Unipuls80/Unidisp/README.md

# Unidisp
Výrobní podklady pro univerzální displej s digitrony, obstarávající napájení a buzení.
