Unipuls80/Unidisp/display_board.kicad_pcb

## KiCad design display_board.kicad_pcb (2023-02-11)

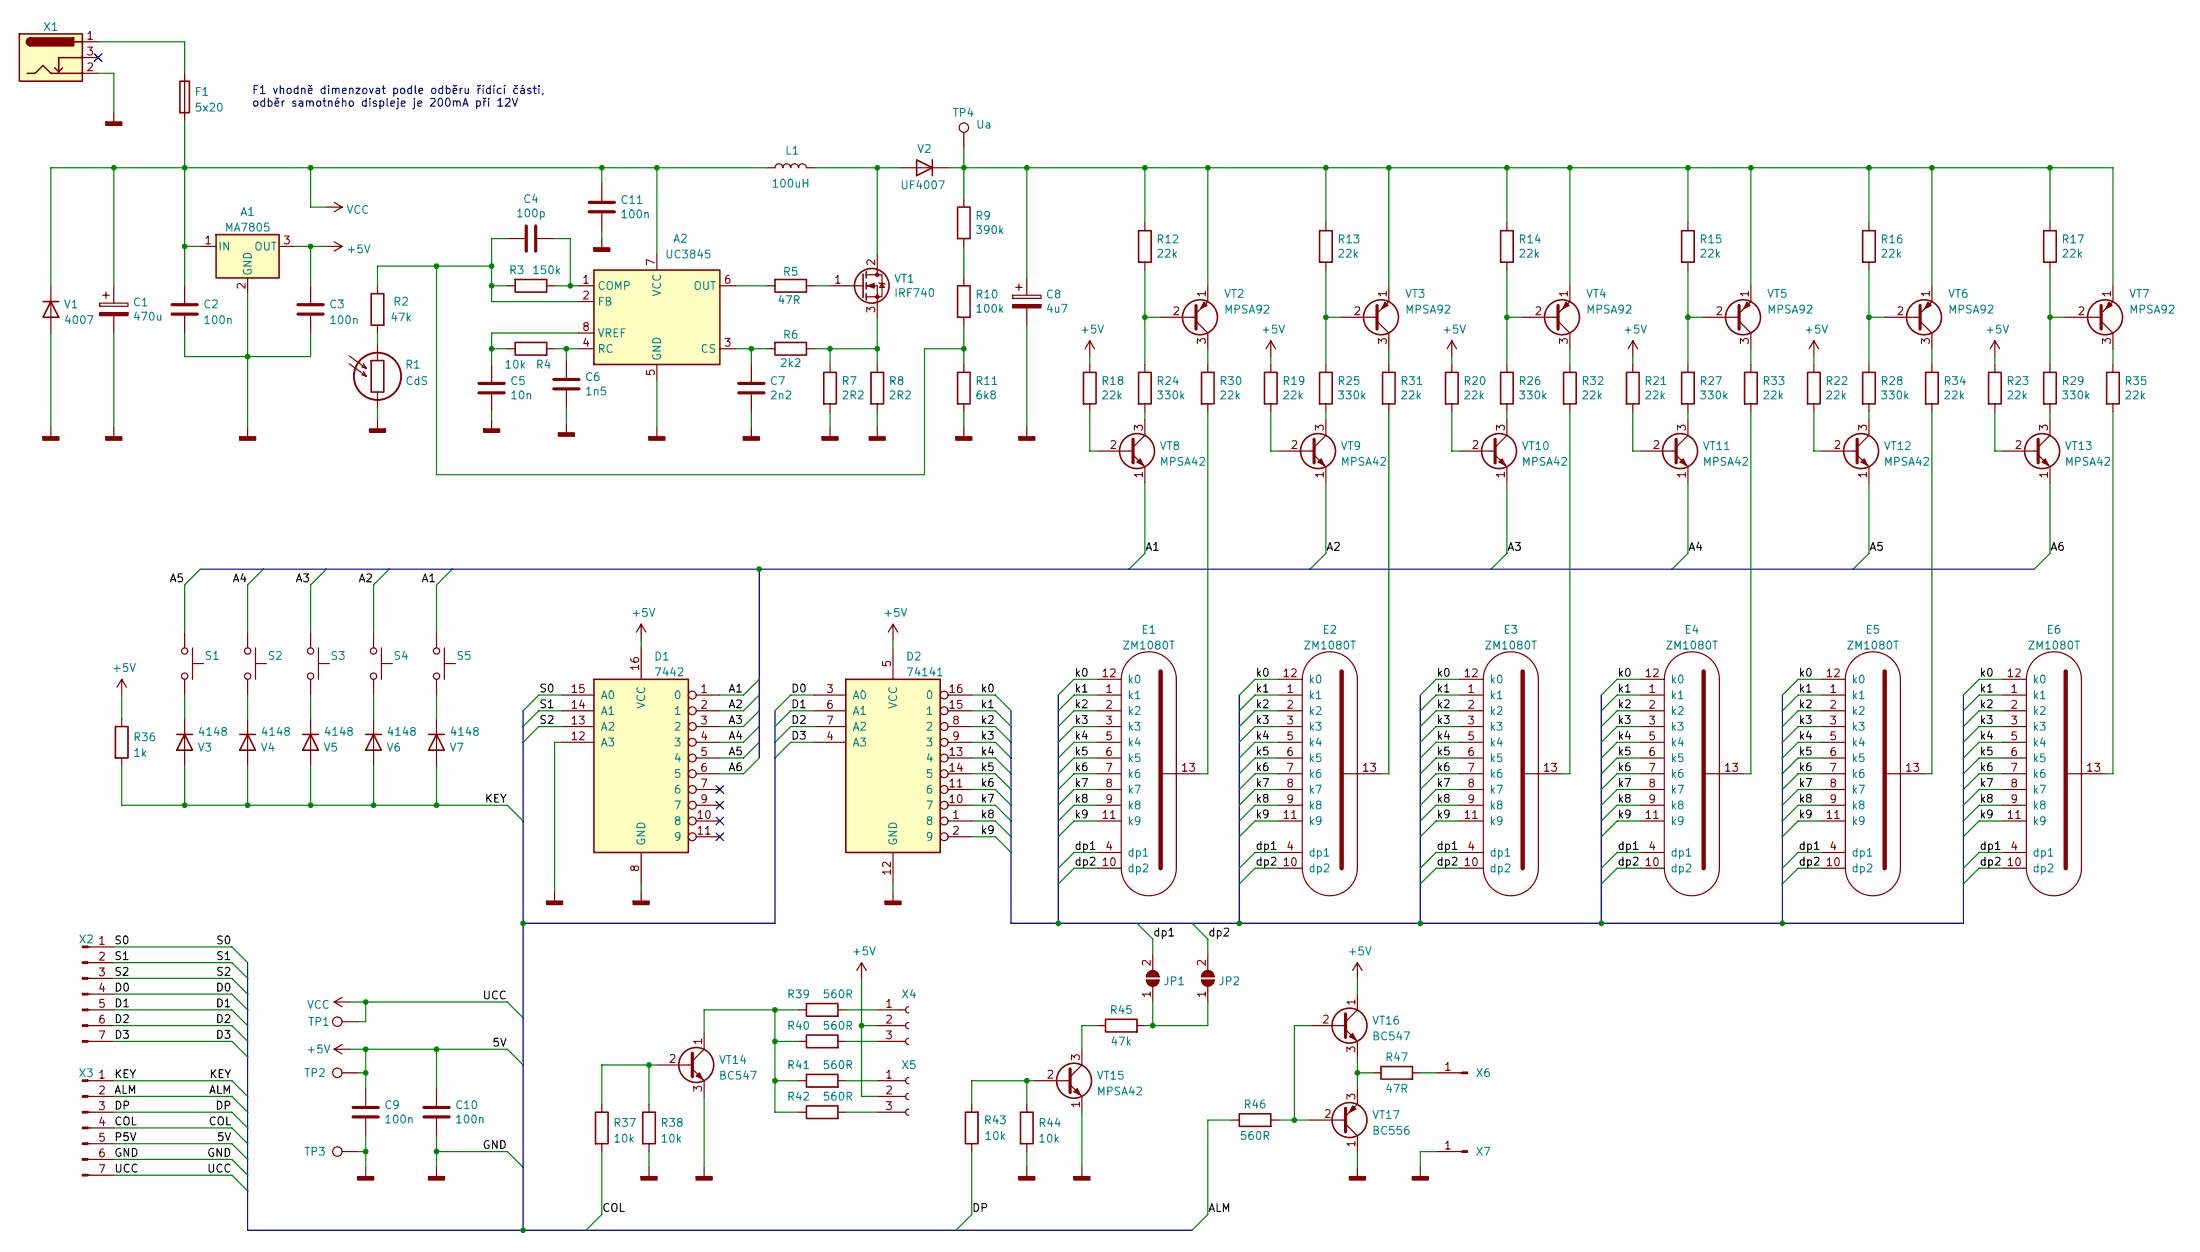
[picture p1: schematic display_board.kicad_sch, Universal nixie clock display board]

Parts:
A1: MA7805; TO-3_78xx
A2: UC3845; DIP-8_W7.62mm
C1: 470u; CP_Radial_D8.0mm_P3.80mm
C2, C3, C9, C10, C11: 100n; C_Disc_D4.3mm_W1.9mm_P5.00mm
C4: 100p; C_Disc_D4.3mm_W1.9mm_P5.00mm
C5: 10n; C_Disc_D4.3mm_W1.9mm_P5.00mm
C6: 1n5; C_Disc_D4.3mm_W1.9mm_P5.00mm
C7: 2n2; C_Disc_D4.3mm_W1.9mm_P5.00mm
C8: 4u7; CP_Radial_D10.0mm_P3.80mm
D1: 7442; DIP-16_W7.62mm
D2: 74141; DIP-16_W7.62mm
E1, E2, E3, E4, E5, E6: ZM1080T; nixie_13pin
F1: 5x20; Fuseholder_Cylinder-5x20mm_Stelvio-Kontek_PTF76_Horizontal_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
JP1, JP2: SolderJumper_2_Open; SolderJumper-2_P1.3mm_Open_Pad1.0x1.5mm
L1: 100uH; L_Radial_D8.7mm_P5.00mm_Fastron_07HCP
R1: CdS; R_LDR_D6.4mm_P3.4mm_Vertical
R2, R45: 47k; R DIN0207 10.16mm
R3: 150k; R DIN0207 10.16mm
R4, R37, R38, R43, R44: 10k; R DIN0207 10.16mm
R5, R47: 47R; R DIN0207 10.16mm
R6: 2k2; R DIN0207 10.16mm
R7, R8: 2R2; R DIN0207 10.16mm
R9: 390k; R DIN0207 10.16mm
R10: 100k; R DIN0207 10.16mm
R11: 6k8; R DIN0207 10.16mm
R12, R13, R14, R15, R16, R17, R18, R19, R20, R21, R22, R23, R30, R31, R32, R33, R34, R35: 22k; R DIN0207 10.16mm
R24, R25, R26, R27, R28, R29: 330k; R DIN0207 10.16mm
R36: 1k; R DIN0207 10.16mm
R39, R40, R41, R42, R46: 560R; R DIN0207 10.16mm
S1, S2, S3, S4, S5: SW_Push; SW_Tactile_SPST_Angled_PTS645Vx58-2LFS
TP1: Vcc; TestPoint_THTPad_D3.0mm_Drill1.5mm
TP2: +5V; TestPoint_THTPad_D3.0mm_Drill1.5mm
TP3: GND; TestPoint_THTPad_D3.0mm_Drill1.5mm
TP4: Ua; TestPoint_THTPad_D3.0mm_Drill1.5mm
V1: 4007; D_DO-41_SOD81_P10.16mm_Horizontal
V2: UF4007; D_DO-41_SOD81_P10.16mm_Horizontal
V3, V4, V5, V6, V7: 4148; D_DO-35_SOD27_P10.16mm_Horizontal
VT1: IRF740; TO-220-3_Horizontal_TabDown
VT2, VT3, VT4, VT5, VT6, VT7: MPSA92; TO-92_Wide
VT8, VT9, VT10, VT11, VT12, VT13, VT15: MPSA42; TO-92_Wide
VT14, VT16: BC547; TO-92_Wide
VT17: BC556; TO-92_Wide
X1: Barrel_Jack_Switch; BarrelJack_Horizontal
X2, X3: Conn_01x07_Male; PinHeader_1x07_P2.54mm_Vertical
X4, X5: Conn_01x03_Female; PinSocket_1x03_P2.54mm_Vertical
X6, X7: Conn_01x01_Male; PinHeader_1x01_P2.54mm_Vertical

Connections:
+5V: A1.3 (OUT), C3.1, C9.1, C10.1, D1.16 (VCC), D2.5 (VCC), R18.1, R19.1, R20.1, R21.1, R22.1, R23.1, R36.1, TP2.1, VT16.1 (C), X3.5, X4.2, X5.2
/A1: D1.1 (0), S5.1, VT8.1 (E)
/A2: D1.2 (1), S4.1, VT9.1 (E)
/A3: D1.3 (2), S3.1, VT10.1 (E)
/A4: D1.4 (3), S2.1, VT11.1 (E)
/A5: D1.5 (4), S1.1, VT12.1 (E)
/A6: D1.6 (5), VT13.1 (E)
/ALM: R46.1, X3.2
/COL: R37.2, X3.4
/D0: D2.3 (A0), X2.4
/D1: D2.6 (A1), X2.5
/D2: D2.7 (A2), X2.6
/D3: D2.4 (A3), X2.7
/DP: R43.1, X3.3
/KEY: R36.2, V3.2 (A), V4.2 (A), V5.2 (A), V6.2 (A), V7.2 (A), X3.1
/S0: D1.15 (A0), X2.1
/S1: D1.14 (A1), X2.2
/S2: D1.13 (A2), X2.3
/dp1: E1.4 (dp1), E2.4 (dp1), E3.4 (dp1), E4.4 (dp1), E5.4 (dp1), E6.4 (dp1), JP1.2 (B)
/dp2: E1.10 (dp2), E2.10 (dp2), E3.10 (dp2), E4.10 (dp2), E5.10 (dp2), E6.10 (dp2), JP2.2 (B)
/k0: D2.16 (0), E1.12 (k0), E2.12 (k0), E3.12 (k0), E4.12 (k0), E5.12 (k0), E6.12 (k0)
/k1: D2.15 (1), E1.1 (k1), E2.1 (k1), E3.1 (k1), E4.1 (k1), E5.1 (k1), E6.1 (k1)
/k2: D2.8 (2), E1.2 (k2), E2.2 (k2), E3.2 (k2), E4.2 (k2), E5.2 (k2), E6.2 (k2)
/k3: D2.9 (3), E1.3 (k3), E2.3 (k3), E3.3 (k3), E4.3 (k3), E5.3 (k3), E6.3 (k3)
/k4: D2.13 (4), E1.5 (k4), E2.5 (k4), E3.5 (k4), E4.5 (k4), E5.5 (k4), E6.5 (k4)
/k5: D2.14 (5), E1.6 (k5), E2.6 (k5), E3.6 (k5), E4.6 (k5), E5.6 (k5), E6.6 (k5)
/k6: D2.11 (6), E1.7 (k6), E2.7 (k6), E3.7 (k6), E4.7 (k6), E5.7 (k6), E6.7 (k6)
/k7: D2.10 (7), E1.8 (k7), E2.8 (k7), E3.8 (k7), E4.8 (k7), E5.8 (k7), E6.8 (k7)
/k8: D2.1 (8), E1.9 (k8), E2.9 (k8), E3.9 (k8), E4.9 (k8), E5.9 (k8), E6.9 (k8)
/k9: D2.2 (9), E1.11 (k9), E2.11 (k9), E3.11 (k9), E4.11 (k9), E5.11 (k9), E6.11 (k9)
GNDD: A1.2 (GND), A2.5 (GND), C1.2, C2.2, C3.2, C5.2, C6.2, C7.2, C8.2, C9.2, C10.2, C11.2, D1.8 (GND), D1.12 (A3), D2.12 (GND), R1.2, R7.2, R8.2, R11.2, R38.2, R44.2, TP3.1, V1.2 (A), VT14.3 (E), VT15.1 (E), VT17.1 (C), X1.2, X3.6, X7.1
unnamed: A2.1 (COMP), C4.1, R3.1
unnamed: A2.2 (FB), C4.2, R2.1, R3.2, R10.2, R11.1
unnamed: A2.3 (CS), C7.1, R6.2
unnamed: A2.4 (RC), C6.1, R4.2
unnamed: A2.6 (OUT), R5.2
unnamed: A2.8 (VREF), C5.1, R4.1
unnamed: C8.1, R9.1, R12.1, R13.1, R14.1, R15.1, R16.1, R17.1, TP4.1, V2.1 (K), VT2.1 (E), VT3.1 (E), VT4.1 (E), VT5.1 (E), VT6.1 (E), VT7.1 (E)
unnamed: E1.13, R30.2
unnamed: E2.13, R31.2
unnamed: E3.13, R32.2
unnamed: E4.13, R33.2
unnamed: E5.13, R34.2
unnamed: E6.13, R35.2
unnamed: F1.1, X1.1
unnamed: JP1.1 (A), JP2.1 (A), R45.2
unnamed: L1.2, V2.2 (A), VT1.2 (D)
unnamed: R1.1, R2.2
unnamed: R5.1, VT1.1 (G)
unnamed: R6.1, R7.1, R8.1, VT1.3 (S)
unnamed: R9.2, R10.1
unnamed: R12.2, R24.1, VT2.2 (B)
unnamed: R13.2, R25.1, VT3.2 (B)
unnamed: R14.2, R26.1, VT4.2 (B)
unnamed: R15.2, R27.1, VT5.2 (B)
unnamed: R16.2, R28.1, VT6.2 (B)
unnamed: R17.2, R29.1, VT7.2 (B)
unnamed: R18.2, VT8.2 (B)
unnamed: R19.2, VT9.2 (B)
unnamed: R20.2, VT10.2 (B)
unnamed: R21.2, VT11.2 (B)
unnamed: R22.2, VT12.2 (B)
unnamed: R23.2, VT13.2 (B)
unnamed: R24.2, VT8.3 (C)
unnamed: R25.2, VT9.3 (C)
unnamed: R26.2, VT10.3 (C)
unnamed: R27.2, VT11.3 (C)
unnamed: R28.2, VT12.3 (C)
unnamed: R29.2, VT13.3 (C)
unnamed: R30.1, VT2.3 (C)
unnamed: R31.1, VT3.3 (C)
unnamed: R32.1, VT4.3 (C)
unnamed: R33.1, VT5.3 (C)
unnamed: R34.1, VT6.3 (C)
unnamed: R35.1, VT7.3 (C)
unnamed: R37.1, R38.1, VT14.2 (B)
unnamed: R39.1, R40.1, R41.1, R42.1, VT14.1 (C)
unnamed: R39.2, X4.1
unnamed: R40.2, X4.3
unnamed: R41.2, X5.1
unnamed: R42.2, X5.3
unnamed: R43.2, R44.1, VT15.2 (B)
unnamed: R45.1, VT15.3 (C)
unnamed: R46.2, VT16.2 (B), VT17.2 (B)
unnamed: R47.1, VT16.3 (E), VT17.3 (E)
unnamed: R47.2, X6.1
unnamed: S1.2, V3.1 (K)
unnamed: S2.2, V4.1 (K)
unnamed: S3.2, V5.1 (K)
unnamed: S4.2, V6.1 (K)
unnamed: S5.2, V7.1 (K)
VCC: A1.1 (IN), A2.7 (VCC), C1.1, C2.1, C11.1, F1.2, L1.1, TP1.1, V1.1 (K), X3.7

Notes on the sheet:
F1 vhodně dimenzovat podle odběru řídící části, odběr samotného displeje je 200mA při 12V

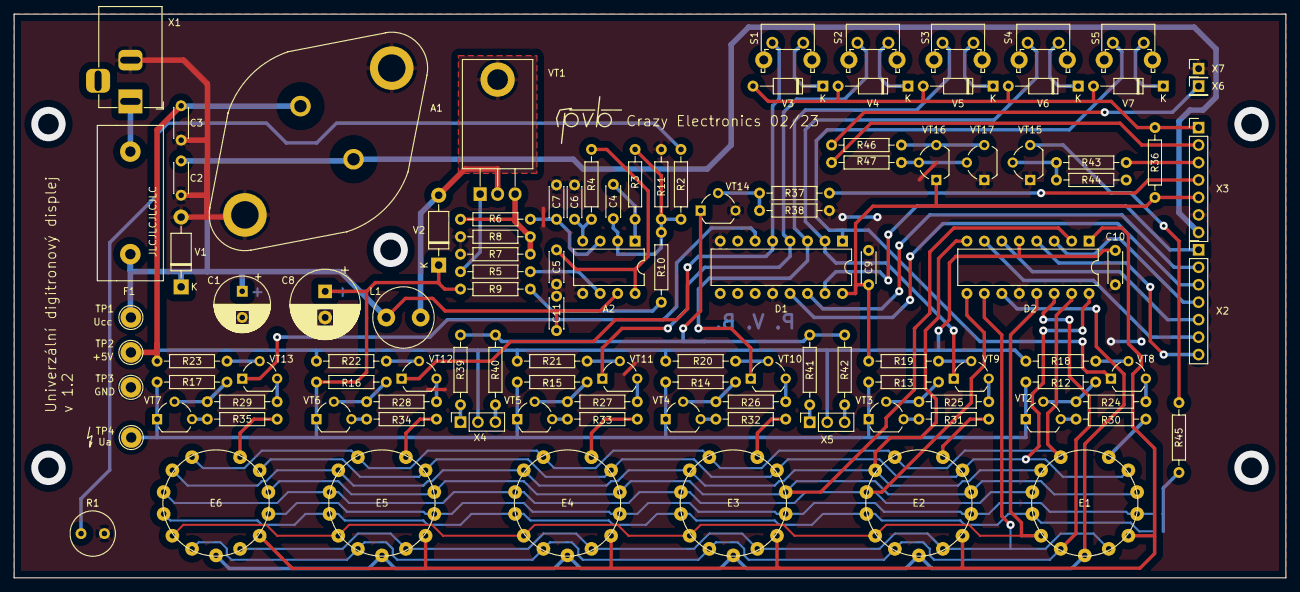
[picture p2: board display_board.kicad_pcb from above]

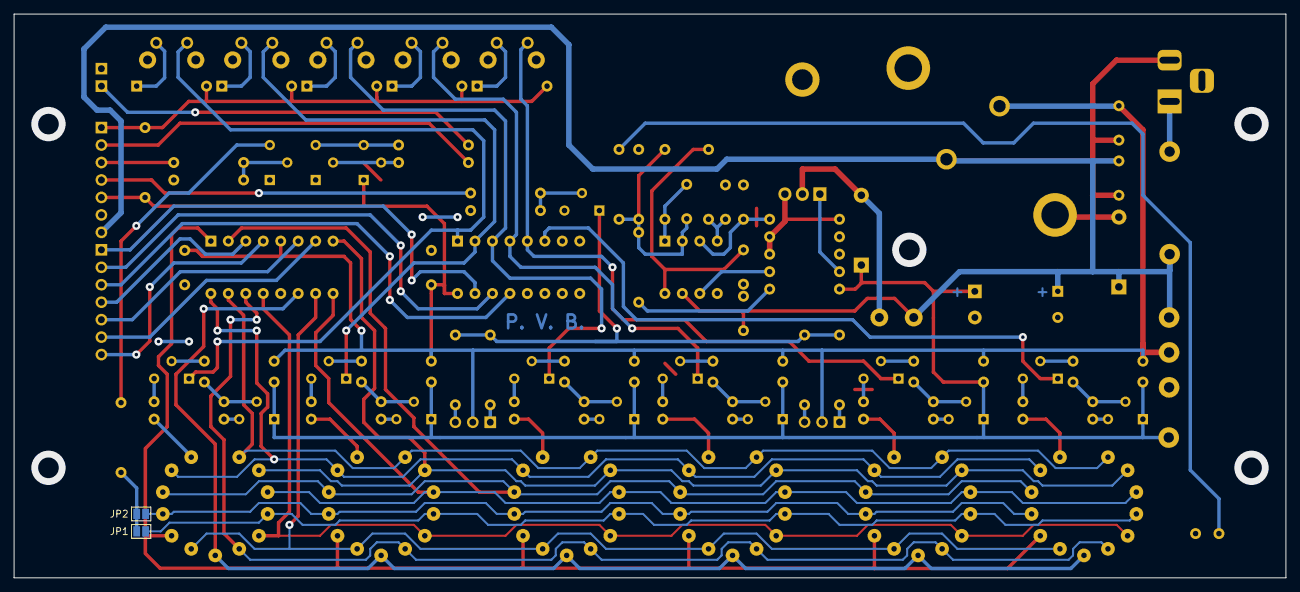
[picture p3: board display_board.kicad_pcb from below]

Board: 2 copper layers, 185.0 x 82.0 mm, 112 parts (2 on the bottom side), 92 nets.
